educalza/Carrinho-esp32cam-ML/README.md

# Carrinho autônomo seguidor de linha com ML

Projeto de um carrinho que aprende a esterçar a partir de imagens da pista. A ESP32-CAM captura a imagem, executa uma rede neural quantizada e envia direção e aceleração por UART para uma ESP32 DevKit, responsável pelo servo e pelos dois motores ligados à ponte H L298N.

## Conteúdo

- [Visão geral](#visão-geral)
- [Hardware](#hardware)
- [Funcionamento etapa a etapa](#funcionamento-etapa-a-etapa)
- [Redes e comunicação](#redes-e-comunicação)
- [Redes neurais](#redes-neurais)
- [Visão computacional](#visão-computacional)
- [Firmwares](#firmwares)
- [Estrutura do repositório](#estrutura-do-repositório)
- [Dados e arquivos grandes](#dados-e-arquivos-grandes)
- [Licença](#licença)

## Visão geral

```mermaid
flowchart LR
    A[Câmera OV2640] --> B[ESP32-CAM]
    B --> C[Pré-processamento 96 x 96]
    C --> D[Modelo CNN INT8]
    D --> E[Steer -1 a +1]
    E --> F[UART S...T...]
    F --> G[ESP32 DevKit]
    G --> H[Servo SG90]
    G --> I[Ponte H L298N]
    I --> J[Dois motores DC]
```

O projeto separa as responsabilidades:

- **ESP32-CAM:** câmera, coleta do dataset e inferência do modelo no modo autônomo.
- **ESP32 DevKit:** recebe `steer` e `throttle`, movimenta o servo e controla os motores.
- **Computador:** processa o dataset, treina, avalia e converte o modelo.
- **Cartão microSD:** armazena imagens e comandos durante a coleta.

## Hardware

- ESP32-CAM AI Thinker com câmera OV2640;
- ESP32 DevKit V1;
- ponte H L298N;
- dois motores DC 3–6 V com caixa de redução;
- microservo SG90;
- duas baterias 18650 em série para os motores;
- LM2596 ajustado para 5 V para os dois ESP32 e o servo;
- cartão microSD para coleta do dataset.

Os dois ESP32 se comunicam por UART. O protocolo é uma linha no formato `S<steer>T<throttle>`, com valores normalizados de `-1` a `+1`. Consulte a ligação completa em [PINAGEM.md](PINAGEM.md).

## Funcionamento etapa a etapa

### 1. Montagem e controle dos atuadores

Grave `firmware/esp32_motor_controller` na ESP32 DevKit. Esse firmware converte o comando de direção em ângulo do servo e o acelerador em PWM para a L298N. Ele também possui um watchdog: se os comandos válidos deixarem de chegar, os motores são desligados.

### 2. Coleta manual do dataset

Grave `firmware/esp32cam_server` na ESP32-CAM. Copie `wifi_config.example.h` para `wifi_config.h` e preencha a rede local. A página de controle envia os comandos do joystick por WebSocket, enquanto a placa encaminha esses comandos ao controlador de motores.

Ao iniciar a gravação, a ESP32-CAM cria uma sessão no cartão SD contendo:

- imagens `frame_XXXXX.jpg` em QVGA, 320 × 240;
- arquivo `log.csv` com imagem, direção, aceleração e timestamps;
- informação sobre a validade e a idade do comando associado ao frame.

Use sessões diferentes para variar sentido da volta, posição inicial, iluminação, velocidade, retas e curvas. A separação posterior é feita por sessão, portanto uma gravação inteira permanece em apenas um conjunto.

### 3. Análise dos dados

Copie as sessões do cartão para uma pasta local `imagens_treino*` e execute:

```powershell
py .\ml_pipeline\01_analisar_dataset.py
```

O relatório mostra a distribuição de direção, aceleração e exemplos de imagens. Verifique especialmente o equilíbrio entre esquerda, reta e direita, além da diversidade de iluminação e pista.

### 4. Pré-processamento

```powershell
py .\ml_pipeline\02_preprocessar.py --raw-dir .\imagens_treino --output-dir .\dataset_processado_novo
```

O pipeline valida os registros, separa sessões inteiras em treino, validação e teste e gera os arrays NumPy. Somente o treino recebe aumento de dados. Use `--require-aligned` quando quiser aceitar apenas amostras cuja associação entre imagem e comando foi comprovada.

### 5. Treinamento

```powershell
py .\ml_pipeline\03_treinar_modelo.py --dataset-dir .\dataset_processado_novo --model-dir .\modelo_novo
```

O treinamento usa o conjunto de validação para escolher o melhor checkpoint. As configurações principais ficam em `ml_pipeline/config.py`. Sempre use um diretório novo para não substituir um modelo anterior.

### 6. Conversão para TensorFlow Lite Micro

```powershell
py .\ml_pipeline\04_converter_tflite.py --dataset-dir .\dataset_processado_novo --model-dir .\modelo_novo
```

A conversão produz um modelo INT8 e o header C++ `modelo_linha.h`. A calibração da quantização usa somente amostras de treino.

### 7. Avaliação

Durante os ajustes, consulte a validação:

```powershell
py .\ml_pipeline\avaliar_precisao.py --split val --dataset-dir .\dataset_processado_novo --model-dir .\modelo_novo
```

Use o teste reservado apenas para a avaliação final. Observe MAE, MSE, R², percentil 95 do erro, acerto do lado das curvas e resultados separados por direção e sessão. Acertar o lado não garante que a intensidade do esterçamento seja suficiente.

### 8. Instalação do modelo

Depois de aprovar o modelo INT8, copie o header gerado para:

```text
firmware/esp32cam_autonomous/modelo_linha.h
```

Grave `firmware/esp32cam_autonomous` somente na ESP32-CAM. A ESP32 DevKit não precisa ser atualizada quando o protocolo permanece o mesmo.

### 9. Execução autônoma

A ESP32-CAM captura o frame, reproduz o pré-processamento do treino, executa a CNN e envia o comando atual à ESP32 DevKit. O firmware vigente usa diretamente a direção prevista pelo modelo; não executa busca, ré ou recuperação heurística da linha.

Antes de aumentar a velocidade, valide retas, curvas para os dois lados e diferentes iluminações com as rodas suspensas e depois em baixa velocidade.

## Redes e comunicação

O modo de coleta manual usa a rede apenas entre a interface de controle e a ESP32-CAM. O modo autônomo executa o modelo localmente e envia comandos diretamente à ESP32 DevKit por UART, portanto não depende de Wi-Fi, Internet, WebSocket ou servidor externo para dirigir.

### Fluxo dos comandos

```mermaid
flowchart LR
    A[Navegador] -->|WebSocket JSON<br/>Wi-Fi| B[ESP32-CAM]
    B -->|UART2<br/>S...T...| C[ESP32 DevKit]
    C --> D[Servo e motores]
    B -->|HTTP MJPEG| A
```

| Tecnologia | Onde é usada | Função principal |
|---|---|---|
| Wi-Fi | Interface ↔ ESP32-CAM | Conecta a placa ao roteador ou hotspot no modo estação |
| HTTP/TCP, porta 80 | `GET /capture` | Entrega uma imagem JPEG única |
| HTTP/TCP, porta 81 | `GET /stream` | Mantém o stream MJPEG separado do servidor de controle |
| WebSocket/TCP, porta 80 | `/ws` | Troca comandos e estados em tempo real usando JSON |
| UART2, 115200 bit/s | ESP32-CAM ↔ ESP32 DevKit | Transporta direção e aceleração até o controlador dos atuadores |
| UDP | Não utilizado | O projeto atual não envia comandos, vídeo nem telemetria por UDP |

### WebSocket e protocolo de controle

A interface abre `ws://<IP-DA-ESP32-CAM>/ws`. O WebSocket mantém uma conexão bidirecional, permitindo controlar o carrinho e consultar o estado sem criar uma nova requisição para cada comando. Entre as mensagens aceitas estão:

```json
{"cmd":"drive","steer":-0.35,"throttle":0.40}
{"cmd":"get_status"}
{"cmd":"rec_start"}
{"cmd":"rec_stop"}
{"cmd":"led","state":true}
{"cmd":"set_config","framesize":8,"quality":10}
```

`steer` e `throttle` são limitados ao intervalo de `-1` a `+1`. Enquanto há movimento, a interface envia `drive` aproximadamente a cada 35 ms, cerca de 28 vezes por segundo. Essa repetição funciona como um heartbeat: se a ESP32 DevKit ficar 300 ms sem receber um comando UART válido, o failsafe desliga os motores.

### Vídeo e prioridade do controle

O stream é MJPEG sobre HTTP, uma sequência contínua de imagens JPEG. Ele roda na porta 81 para que a conexão longa de vídeo não ocupe o servidor da porta 80, usado pelo WebSocket e pela captura individual. O firmware também cede tempo entre frames para que vídeo e controle compartilhem CPU e rádio.

O vídeo consome muito mais banda que as mensagens JSON. Se houver atraso no controle durante a coleta, reduza a qualidade ou resolução do stream, aproxime o ponto de acesso e evite vários clientes conectados simultaneamente. A gravação do dataset exige QVGA, 320 × 240.

### Wi-Fi, endereço e reconexão

A ESP32-CAM usa o modo estação (`WIFI_STA`) e recebe seu endereço IP da rede. SSID, senha, hostname e timeout ficam em `firmware/esp32cam_server/wifi_config.h`, criado a partir de `wifi_config.example.h`. O IP aparece no monitor serial após a conexão e deve ser informado na interface. Como ele normalmente é atribuído por DHCP, pode mudar após uma reinicialização; uma reserva de IP no roteador evita essa mudança.

O firmware verifica a conexão periodicamente e tenta reconectar quando o Wi-Fi cai. Durante a condução manual, uma queda interrompe os comandos e o failsafe da ESP32 DevKit para os motores.

### Por que não há UDP

UDP poderia reduzir parte do overhead e seria uma opção para telemetria tolerante a perdas. Porém, ele não garante entrega, ordem nem detecção de desconexão. Para este projeto, WebSocket oferece uma conexão persistente, mensagens bidirecionais e integração direta com o navegador. A troca por UDP só faria sentido após medir a rede e demonstrar que WebSocket é o gargalo; ela também exigiria sequência de pacotes, heartbeat e descarte de comandos atrasados.

### Segurança da rede

HTTP e `ws://` não usam criptografia, e o firmware não autentica clientes. Use a coleta em uma rede local confiável e não exponha as portas da ESP32-CAM à Internet. O arquivo real de credenciais permanece fora do Git.

## Redes neurais

### Problema aprendido

O treinamento é uma **regressão supervisionada por imitação**. Cada imagem é associada ao comando humano de direção:

- `-1`: esterçamento máximo para a esquerda;
- `0`: direção central;
- `+1`: esterçamento máximo para a direita.

A rede aprende apenas `steer`. O firmware calcula o `throttle` a partir da intensidade da curva e das configurações de velocidade.

### Arquitetura atual

A entrada possui `96 × 96 × 1` pixels em escala de cinza. A CNN contém:

1. convolução com 4 filtros 5 × 5 e stride 4;
2. convolução com 8 filtros 3 × 3 e stride 2;
3. convolução com 12 filtros 3 × 3 e stride 2;
4. `GlobalAveragePooling2D`;
5. camada densa com 16 neurônios e ReLU;
6. saída única com `tanh`, limitada entre `-1` e `+1`.

O modelo usa Adam, perda MSE e acompanha MAE. `ModelCheckpoint` preserva a menor perda de validação, `EarlyStopping` interrompe épocas sem melhoria e `ReduceLROnPlateau` reduz a taxa de aprendizado quando necessário.

### Separação e vazamento de dados

As sessões são separadas antes do aumento de dados. Isso evita que frames quase idênticos da mesma volta apareçam simultaneamente em treino e validação. Flip horizontal e variação de brilho/contraste são aplicados somente no treino; ao espelhar a imagem, o sinal do `steer` também é invertido.

### Quantização e execução embarcada

O modelo Keras é convertido para INT8 para caber e executar com menor latência na ESP32-CAM. O firmware usa TensorFlow Lite Micro e convoluções ESP-NN otimizadas. Na inicialização, as convoluções otimizadas são comparadas com a implementação de referência antes de o movimento ser habilitado.

O pré-processamento escreve diretamente no tensor INT8, e o firmware tenta manter arena, tabelas e modelo em memória interna para melhorar a localidade. Essas otimizações reduzem latência, mas não corrigem erros causados por dados insuficientes ou mudança de iluminação.

### Limitações importantes

- Métricas offline boas não garantem estabilidade com o carrinho em movimento.
- `direction_accuracy` mede o lado, não a intensidade correta da curva.
- Iluminação, reflexos, textura do piso, altura e inclinação da câmera alteram a distribuição das imagens.
- Se curvas de um lado forem gravadas em uma condição visual específica, a rede pode aprender essa correlação indesejada.
- Para corrigir uma condição nova, colete exemplos reais dela e mantenha sessões independentes para validação e teste.

## Visão computacional

### Processamento usado pela rede neural

No modo autônomo, a OV2640 captura imagens QVGA em escala de cinza. O firmware reduz a imagem para 96 × 96 usando a mesma média inteira 2 × 2 empregada pelo pipeline, normaliza os pixels e os quantiza para INT8. Manter o mesmo processamento no computador e na placa evita diferença entre treinamento e inferência.

A CNN recebe os pixels processados e aprende sozinha os padrões relevantes. Não há uma regra explícita dizendo onde está a linha; essa representação é aprendida a partir dos exemplos e comandos.

### Iluminação e câmera

Mais luz não significa automaticamente uma imagem melhor. Exposição automática, brilho do piso e reflexos podem diminuir o contraste ou produzir uma aparência diferente daquela vista no treino. Para maior robustez:

- grave todos os tipos de direção em condições variadas;
- evite associar apenas curvas direitas a um local escuro e curvas esquerdas a um local claro;
- mantenha posição, foco e inclinação da câmera consistentes;
- inclua na coleta as condições reais da pista de teste;
- compare amostras antes e depois do pré-processamento.

## Firmwares

| Pasta | Placa | Finalidade |
|---|---|---|
| `firmware/esp32_motor_controller` | ESP32 DevKit | Servo, motores, PWM, protocolo UART e failsafe |
| `firmware/esp32cam_server` | ESP32-CAM | Controle manual via Wi-Fi, stream e gravação no SD |
| `firmware/esp32cam_autonomous` | ESP32-CAM | Inferência CNN INT8 e pilotagem autônoma |

## Estrutura do repositório

```text
firmware/                 Código das duas placas
interface_controle/       Interface web do controle manual
ml_pipeline/              Análise, processamento, treino, conversão e avaliação
tests/                    Testes do protocolo, pipeline e otimizações
PINAGEM.md                Ligações elétricas e pinos
IMPLEMENTACAO_ML.md       Histórico técnico das alterações
```

Os detalhes do pipeline estão em [ml_pipeline/README.md](ml_pipeline/README.md), e as instruções de gravação do piloto em [firmware/esp32cam_autonomous/COMO_GRAVAR_ARDUINO.md](firmware/esp32cam_autonomous/COMO_GRAVAR_ARDUINO.md).

## Dados e arquivos grandes

Datasets, arrays processados, modelos de treinamento, gráficos e backups compactados são ignorados pelo Git. O repositório mantém o código e o header do modelo instalado no firmware.

Os dados e o modelo treinado estão disponíveis no Hugging Face:

- **Dataset:** [ESP32-CAM Autonomous Line-Following Car Dataset](https://huggingface.co/datasets/pdDuduzin/ESP32-CAM_Autonomous_Line-Following_Car_Dataset)
- **Modelo:** [ESP32-CAM Autonomous Line-Following Car Model](https://huggingface.co/pdDuduzin/ESP32-CAM_Autonomous_Line-Following_Car_Model)

O modelo publicado corresponde ao `modelo_v3`. Seu `modelo_linha.h` é o mesmo instalado em `firmware/esp32cam_autonomous`. Use essas páginas para baixar os artefatos sem adicionar arquivos pesados ao repositório Git. Ao reproduzir um treinamento, registre a versão do dataset e a divisão de sessões utilizada.

As credenciais Wi-Fi também não são versionadas. Em uma cópia nova do projeto, duplique `firmware/esp32cam_server/wifi_config.example.h` como `wifi_config.h` e preencha os valores localmente.

## Licença

Este projeto é distribuído sob a [Apache License 2.0](LICENSE). Componentes de terceiros mantêm seus próprios arquivos e termos de licença.
