educalza/Carrinho-esp32cam-ML/firmware/esp32cam_autonomous/optimized_conv.h

#pragma once
#include <stddef.h>
#include <stdint.h>
#include "tensorflow/lite/micro/kernels/conv.h"

namespace car_ml {
TFLMRegistration RegisterOptimizedConv();
// Verification is used only before driving; scratch may be reused afterwards.
void SetConvVerification(uint8_t* scratch, size_t size);
unsigned OptimizedConvCalls();
unsigned ReferenceConvCalls();
}
