educalza/Carrinho-esp32cam-ML/firmware/esp32cam_server/wifi_config.example.h

// Copie este arquivo para wifi_config.h antes de compilar.
#ifndef WIFI_CONFIG_H
#define WIFI_CONFIG_H

#define WIFI_SSID               "NOME_DA_REDE"
#define WIFI_PASSWORD           "SENHA_DA_REDE"
#define WIFI_CONNECT_TIMEOUT_MS 10000
#define WIFI_HOSTNAME           "esp32cam-carrinho"

#endif // WIFI_CONFIG_H
