educalza/Carrinho-esp32cam-ML/(commit log)

2026-09-14 carrinho funcionando para criacao do dataset
2026-09-16 primeiro treino
    [log.csv]
2026-09-16 termino primeiro dataset 8k img
    [log.csv]
2026-09-24 Remove datasets pesados do repositorio
    [log.csv]
2026-09-25 retirada do piloto automatico com problemas
    [test_ml_pipeline.py]
2026-09-25 conteudo de redes
